Bernardita-lobo/2025-solenoid-trigger/3dmodels/rean-NYS367-RCA-panel/Neutrik Rean NYS 367 render 1.png

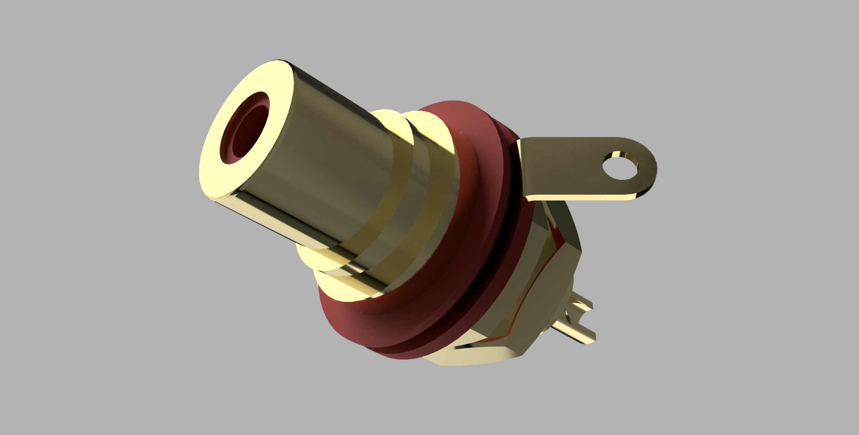
3dmodels/rean-NYS367-RCA-panel/Neutrik Rean NYS 367 render 1.png
