Bernardita-lobo/2025-solenoid-trigger/3dmodels/jack-dc-panel/DC Jack Panel Mount ASSY.STEP

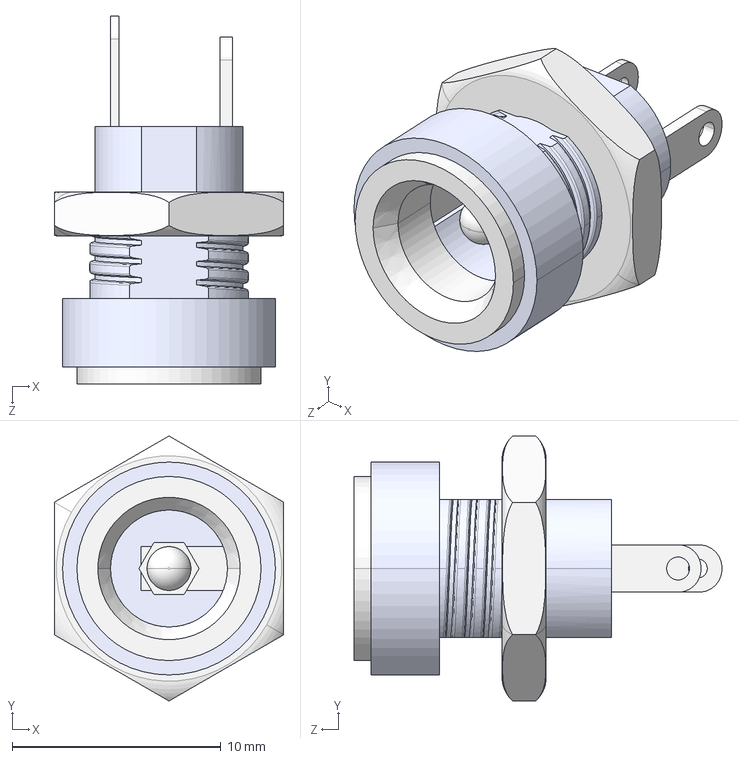
[picture p5: CAD file, 2025-07-28]
3dmodels/jack-dc-panel/DC Jack Panel Mount ASSY.STEP
11.0 x 12.7 x 17.6 mm
DC Jack Panel Mount Base
DC Jack Panel Mount Nut
