Bernardita-lobo/2025-solenoid-trigger/3dmodels/caja-hammond1590d/164_1590D.stp

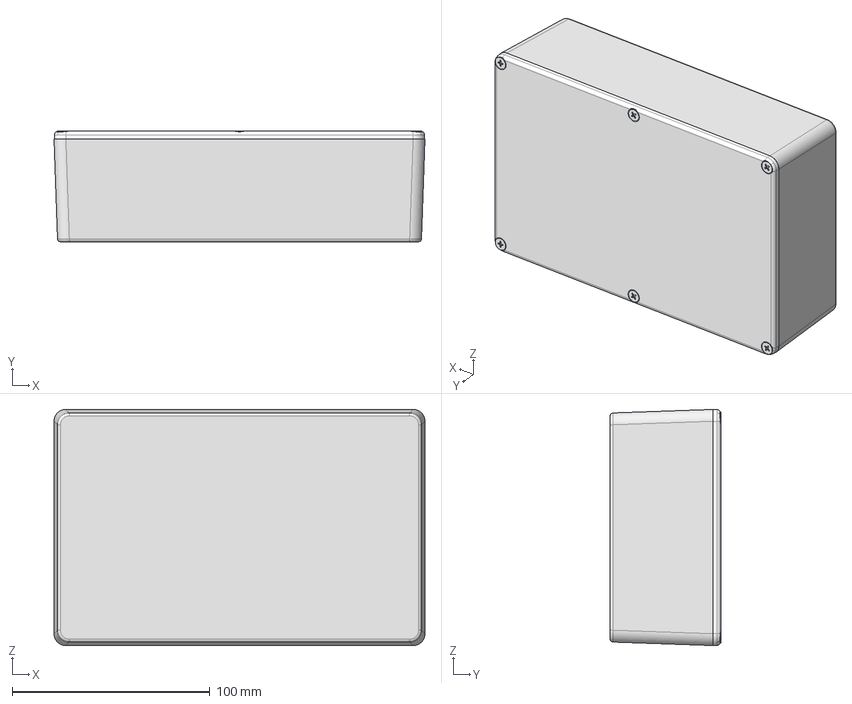
[picture p6: CAD file, 2025-07-28]
3dmodels/caja-hammond1590d/164_1590D.stp
187.8 x 56.0 x 119.5 mm
