Bernardita-lobo/2025-solenoid-trigger/3dmodels/rean-NYS367-RCA-panel/Neutrik Rean NYS 367.step

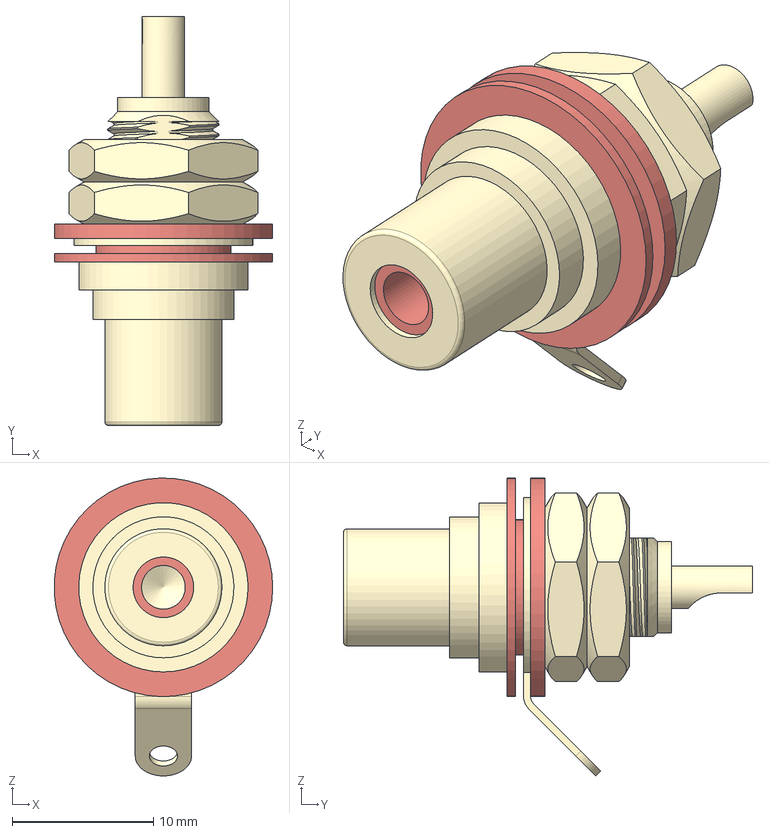
[picture p7: CAD file, 2025-07-28]
3dmodels/rean-NYS367-RCA-panel/Neutrik Rean NYS 367.step
15.5 x 29.0 x 21.1 mm
Housing
Nuts
Washers
Ground Contact
