Bernardita-lobo/2025-solenoid-trigger/3dmodels/jack-dc-panel/DC Jack Panel Mount Base.SLDPRT

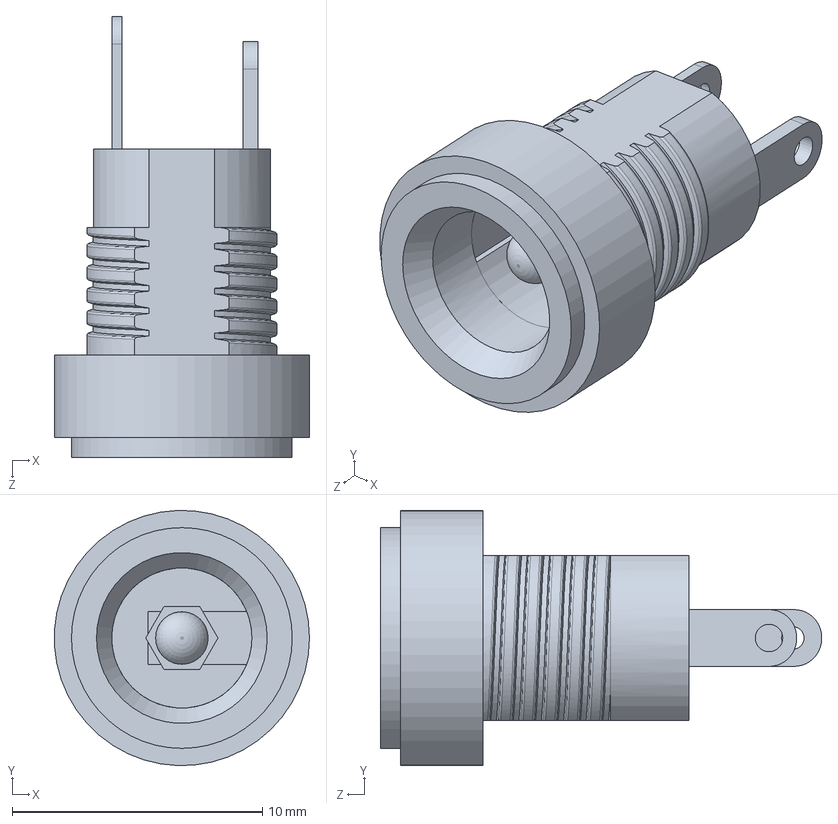
[picture p8: CAD file, 2025-07-28]
3dmodels/jack-dc-panel/DC Jack Panel Mount Base.SLDPRT
10.2 x 10.2 x 17.6 mm
