Bernardita-lobo/2025-solenoid-trigger/3dmodels/jack-dc-panel/DC Jack Panel Mount Nut.SLDPRT

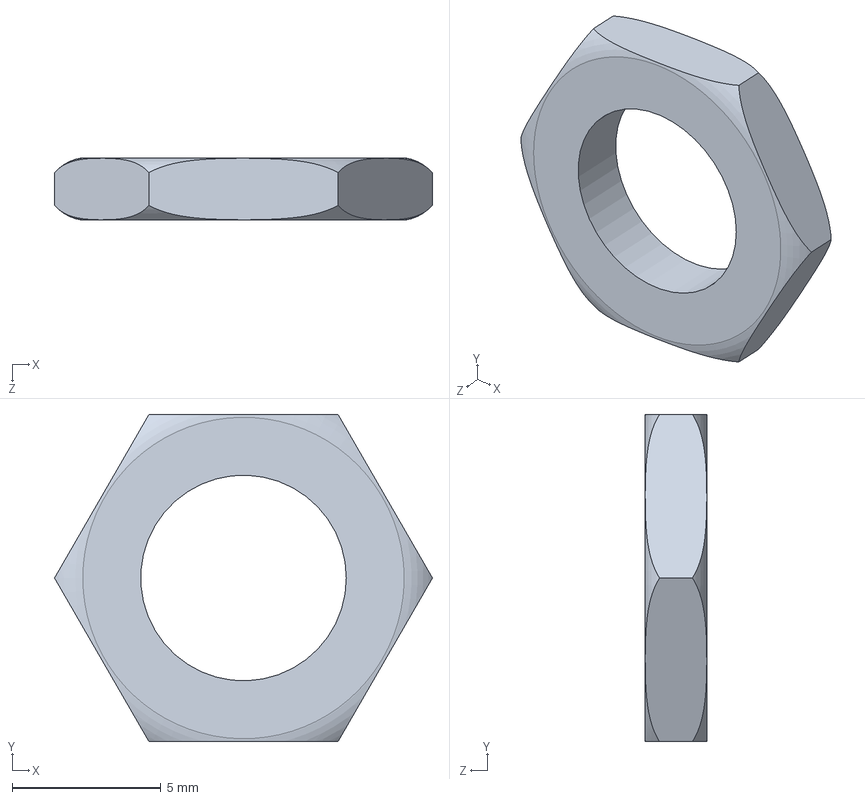
[picture p9: CAD file, 2025-07-28]
3dmodels/jack-dc-panel/DC Jack Panel Mount Nut.SLDPRT
12.7 x 11.0 x 2.10 mm
