Bernardita-lobo/2025-solenoid-trigger/(list of files, cad)

Other CAD files:
planimetria-caja/plantillas/vista-superior.dwg
planimetria-caja/plantillas/vista-frontal.dwg
planimetria-caja/plantillas/vista-inferior.dwg
3dmodels/jack-dc-panel/DC Jack Panel Mount ASSY.SLDASM
3dmodels/jack-dc-panel/DC Jack Panel Mount ASSY.SLDPRT
