Bernardita-lobo/2025-solenoid-trigger/strangeTrig_sch.pdf

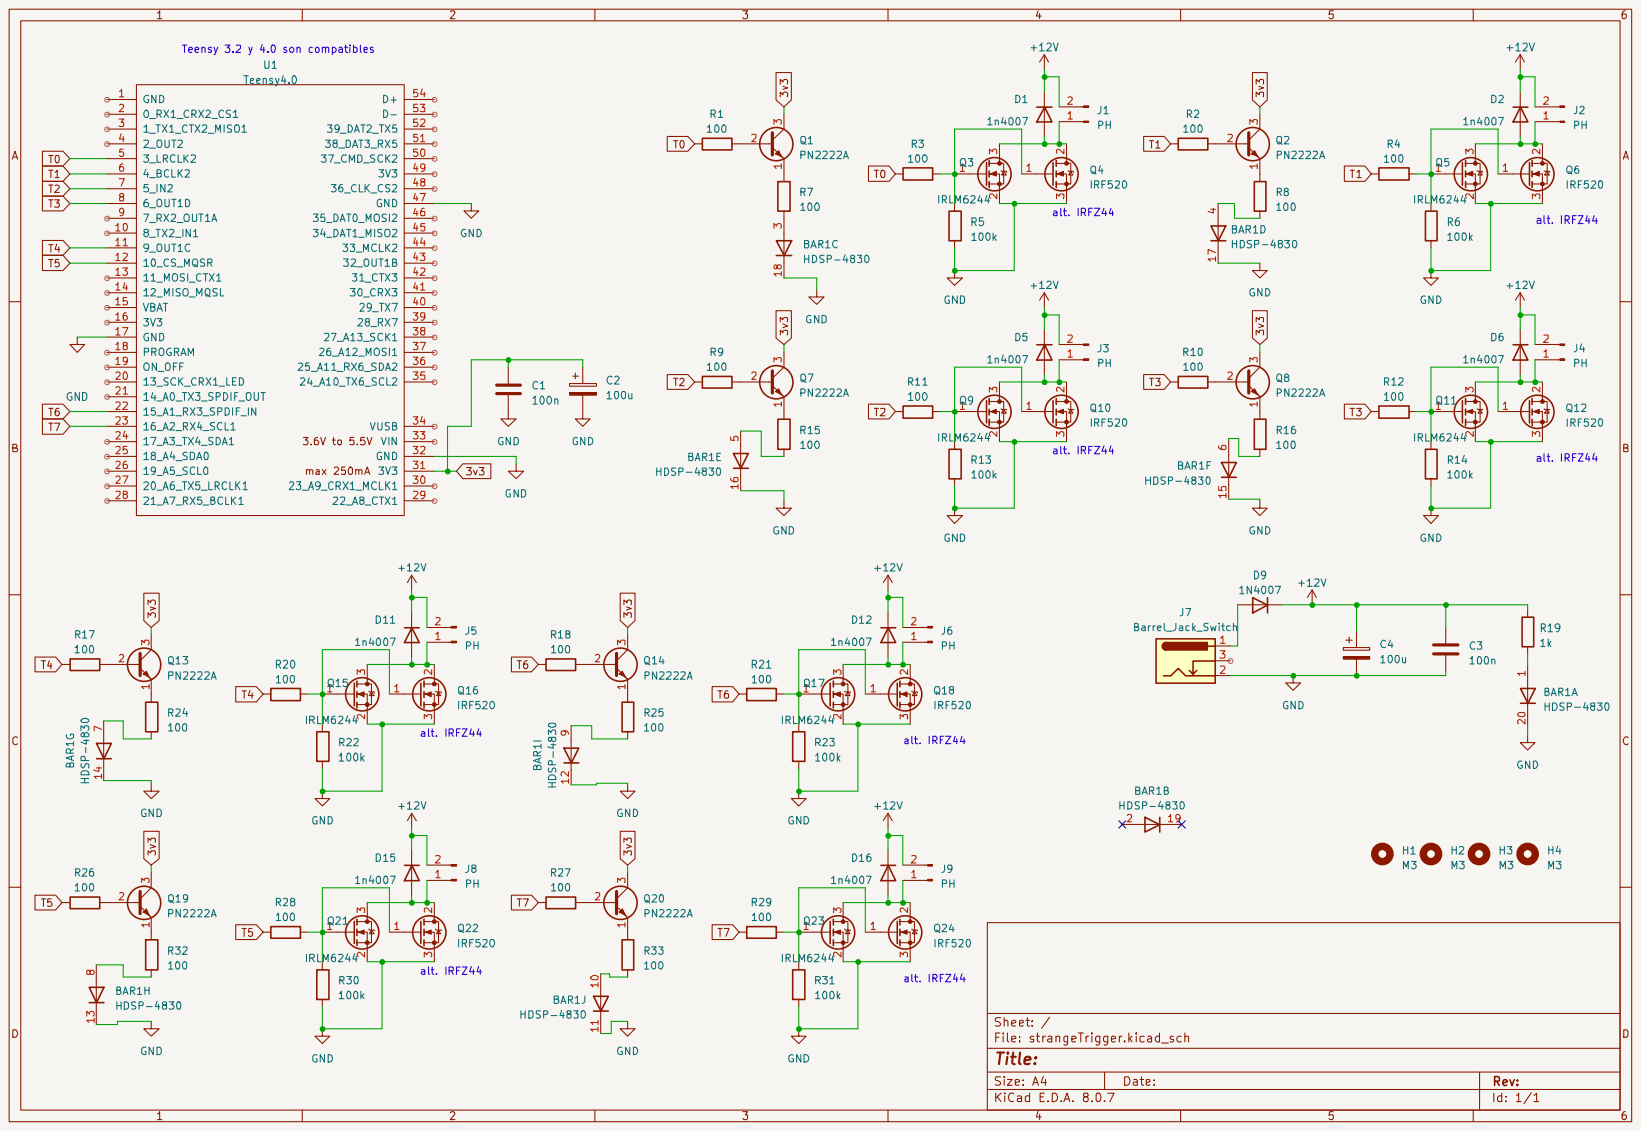
[picture p10: page 1]
