Bernardita-lobo/2025-solenoid-trigger/planimetria-caja/plantillas/caja-hammond-01.pdf

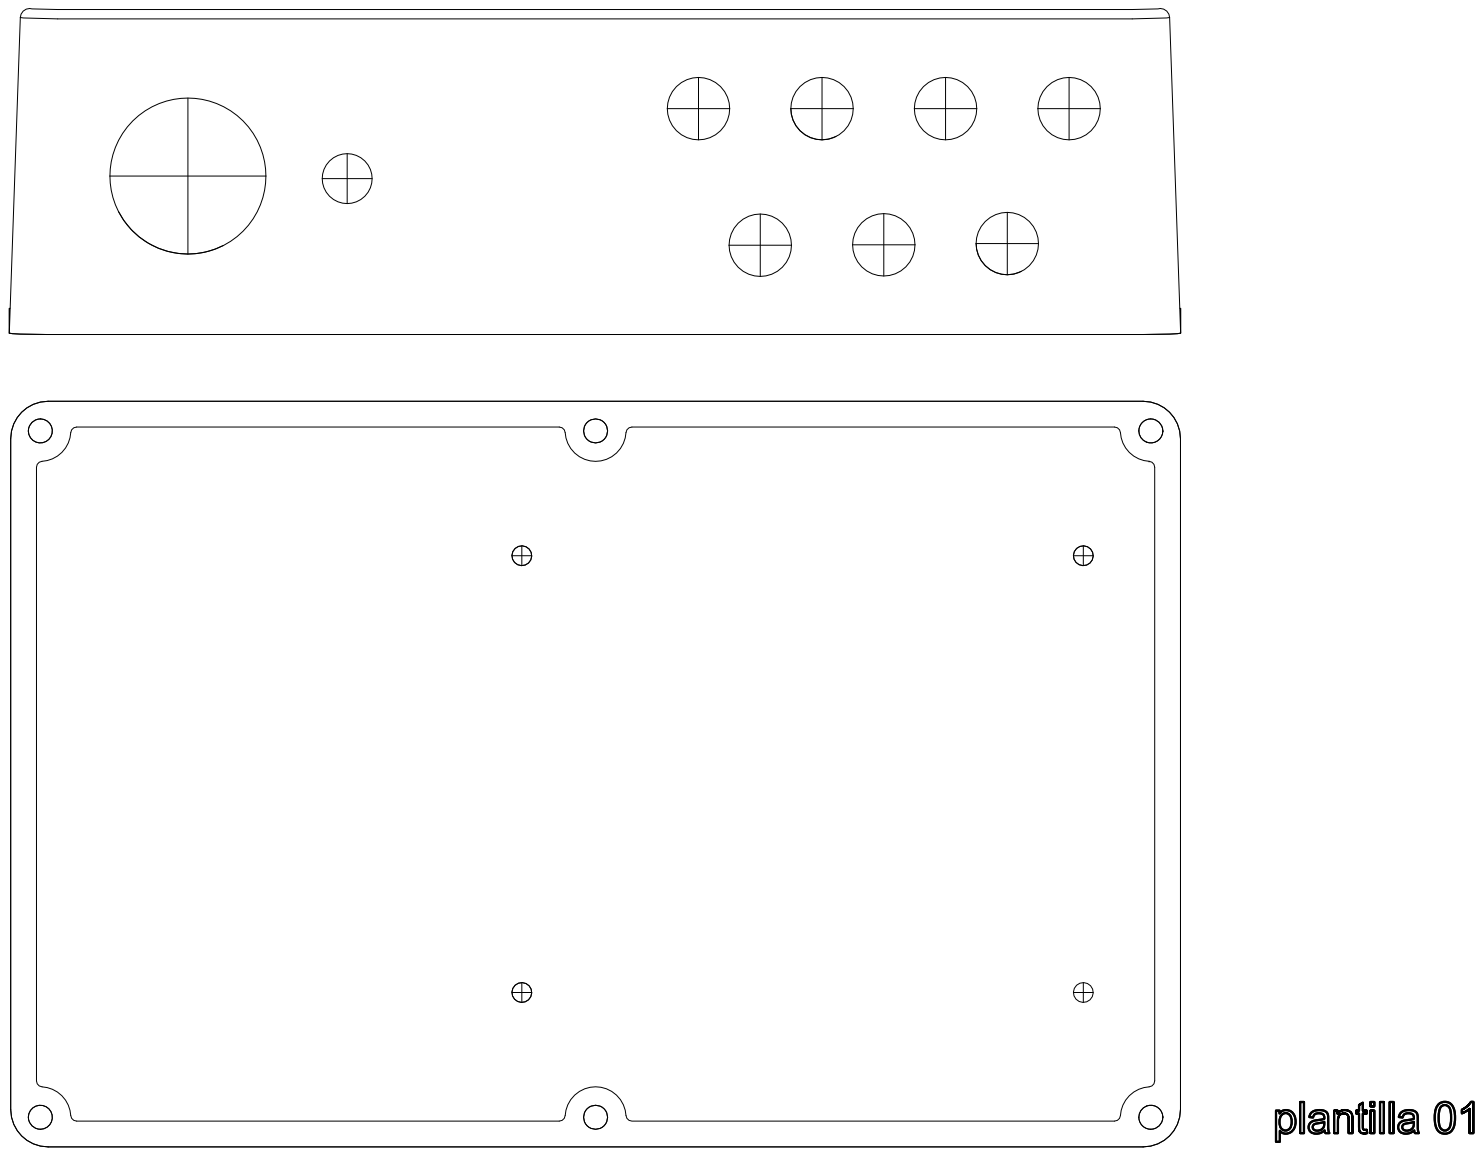
[picture p11: page 1]
