Bernardita-lobo/2025-solenoid-trigger/planimetria-caja/plantillas/caja-hammond-02.pdf

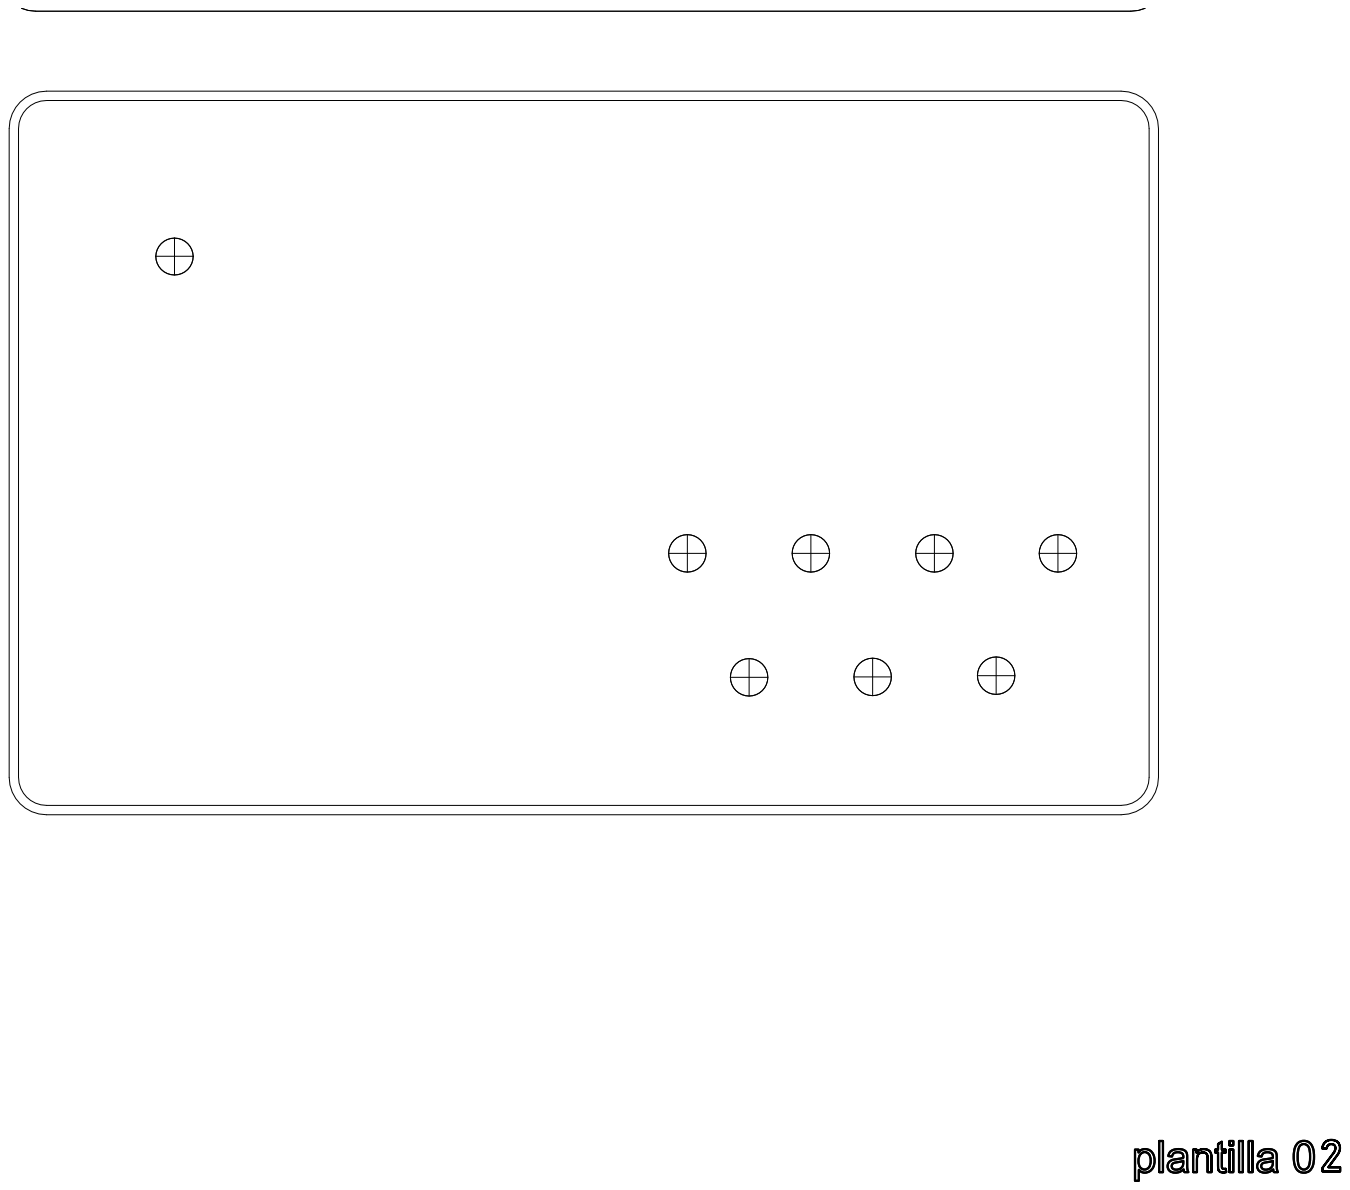
[picture p12: page 1]
