Bernardita-lobo/2025-solenoid-trigger/3dmodels/rean-NYS367-RCA-panel/NYS367-2.pdf

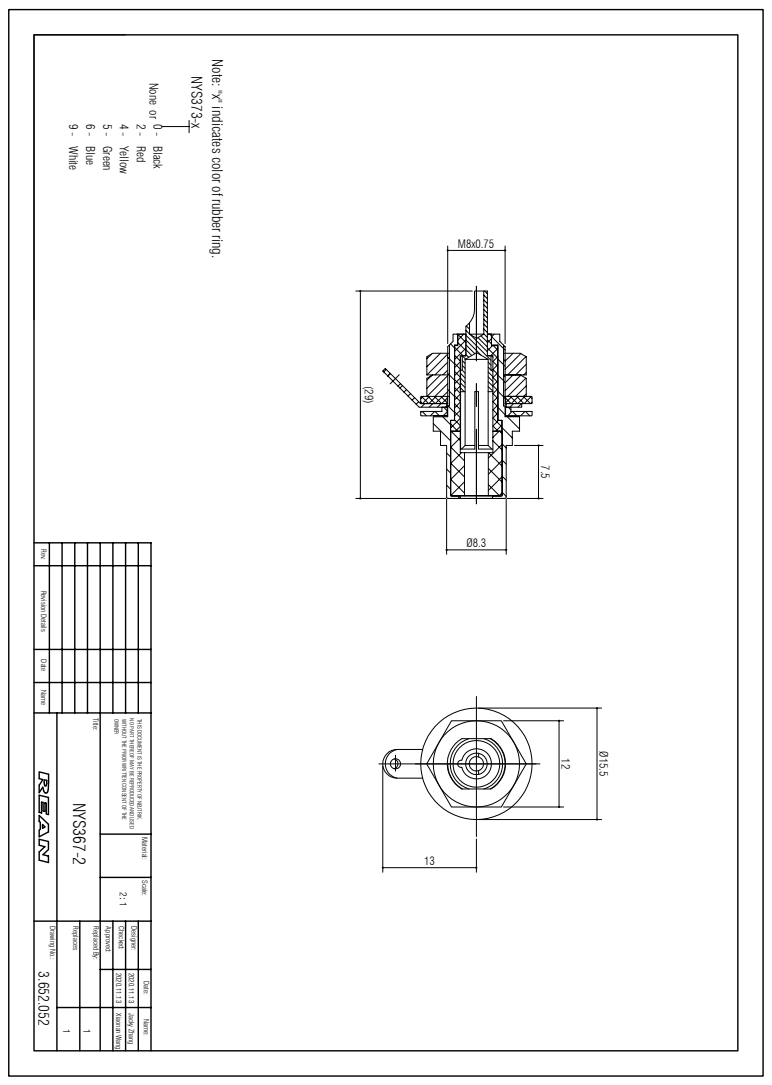
[picture p13: page 1]

NYS367-2 2:1 11 OWNER WITHOUT THE PRIOR WRITTEN CONSENT OF THE NO PART THEREOF MAY BE REPRODUCED AND USED THIS DOCUMENT IS THE PROPERTY OF NEUTRIK. Material: Scale: Title: Date: Name: Approved: Checked: Designer: Jacky Zhang Drawing No.: Replaces: Replaced By: Name Date Revision Details Rev. 3.652.052 2020.11.13 Xiaonan Wang 2020.11.13 Note: "x" indicates color of rubber ring. NYS373-x0 - Black 2 - Red 4 - Yellow 5 - Green 6 - Blue 9 - White None or (29)
