Bernardita-lobo/2025-solenoid-trigger/strangeTrigger_2025/strangeINFO.ino

// codigo original @misaaaaaa
// v0.0.1 2025-05-11

// siguientes versiones
// por @misaaaaaa y @montoyamoraga

// para teensy 4.0

// calibrar el ancho del tiempo de activacion del trigger
// segun velocidad de la nota midi

// hay 3 notas midi, una por woodblock
// podemos incluso hacerlo con siete

// input: nota midi con velocidad midi
// procesamos
// out[]

// variables de longitud de pulso minimo y maximo

// operador modulo %12 para llevarlo a escala 0-11
// do, re, mi, fa, sol, la, si
