Bernardita-lobo/2025-solenoid-trigger/(commit log)

2024-11-05 modified objects
    controller modificado para 8 canales midi
    teensy cambiada la frecuencia pwm y mejorada estabilidad al iniciar
2025-07-15 añadido bom
    [bom.csv]
2025-07-15 desacoplar funcion led interno
2025-07-28 añadido 3d jack dc rca y usb
    [DC Jack Panel Mount ASSY.SLDASM, DC Jack Panel Mount ASSY.SLDPRT, DC Jack Panel Mount ASSY.STEP, DC Jack Panel Mount Base.SLDPRT, DC Jack Panel Mount Nut.SLDPRT, Neutrik Rean NYS 367.step]
2025-07-28 añadido modelo 1590d
    [164_1590D.stp]
2025-07-29 añadido 3d pcb
2025-08-06 seguir ordenando codigo, borrar serial print
2025-08-06 borrar mas serial print y control change
